OnceWasPerfect/BleController/WirelessFoot.ino

#include "headers\RadioSetup.h"  //Radio setup routine
#include <Adafruit_LIS3DH.h>  //Accelerometer library
#include <Adafruit_Sensor.h>  //Accelerometer library
#include <SPI.h>  //SPI hardware library

//Debug setup
//#define DEBUG //comment out to disable debug
#ifdef DEBUG
 #define DEBUG_PRINT(x)     Serial.print (x)
 #define DEBUG_PRINTLN(x)  Serial.println (x)
 #define DEBUG_BEGIN(x)     Serial.begin(x)
#else
 #define DEBUG_PRINT(x)
 #define DEBUG_PRINTLN(x) 
 #define DEBUG_BEGIN(x)
#endif

#define AVERAGEFACTOR 20  //How many samples to average for a location

//Setup up a struct to pass the data
typedef struct locationData
{
  int x;  //Will hold the x axis info
  int y;  //Will hold the y axis info
};

//Accelerometer setup
Adafruit_LIS3DH lis = Adafruit_LIS3DH();  //Create acc object

void setup()
{
  DEBUG_BEGIN(115200);
  //Accelerometer setup 
  lis.begin(0x18);  //Start the accelerometer object
  lis.setRange(LIS3DH_RANGE_16_G);  //Set RANGE for accelerometer 2, 4, 8 or 16 G!

  //Radio setup
  radioSetup();
}

void loop()
{
  locationData location;  //Object to hold location data

  location = averageLocation();  //Average the sensor data and stick it in location

  //Setup for radio send
  byte tx_buf[sizeof(location)] = {0};  //buffer to send location
  memcpy(tx_buf, &location, sizeof(location));  //copy location to transmit buffer

  //Send location object
  nrf24.send((uint8_t *)tx_buf, sizeof(location));
  nrf24.waitPacketSent();
}

locationData averageLocation()
{
  locationData average;
  long total[] = {0,0};  //Long to hold the running total

  for (int i = 0; i < AVERAGEFACTOR; i++)  //take AVERAGEFACTOR samples
  {
    lis.read();  //Get new data from sensor

    total[0] += lis.x;  //Running total of x locations
    total[1] += lis.y;  //Running total of y locations
  }

  average.x = total[0] / AVERAGEFACTOR;  //Average the x location
  average.y = total[1] / AVERAGEFACTOR;  //Average the y location

  return average; //Return the average as a location
}
  
