OnceWasPerfect/BleController/(commit log)

2019-07-30 Blue tooth controller with updated buttons
2019-07-31 Update readming with wiring info
2019-07-31 wiring diagram
2019-07-31 updated readme with wiring diagram
2019-08-02 Change mainButton to pin 11
2019-08-03 use define for button pins
2019-08-05 Fix new buttons and delete old code
2019-08-09 initial test with nano boards
